chalume/CAP-CE6C-CRESUS/AXINT_CE6C_CRESUS/BOM proto-electronics PASSIF.xlsx

# | reference | value | Footprint | Ref Fabricant | Ref Fournisseur 1 | Quantity
1 | C30, C33, C34, C40, C41, C42, C43, C47, C49, C52, C54, C62, C63, C64, C65, C66, C67, C70, C71, C73, C77, C88, C92, C93, C95, C96, C98, C99, C100, C101 | 10nF_100V_0603 | C_0603_1608Metric | C0603X103K1RAC3316 | 399-C0603X103K1RAC3316CT-ND | 30
2 | C8, C12, C19, C20, C21, C22, C35, C36, C38, C48, C108, C109, C110, C111, C112, C113, C114, C115, C116, C117, C118, C119, C120, C121, C122, C123, C124, C125, C126 | 0.1µF_50V_0603 | C_0603_1608Metric | 06035C104KAT2A | 478-5052-1-ND | 29
3 | C1, C2, C3, C4, C5, C6, C7, C9, C24, C25, C26, C27, C28, C31, C51, C53, C59, C60, C68, C69, C80, C82, C83, C84, C85, C86 | 1µF_25V_0603 | C_0603_1608Metric | CL10B105KA8NNNC | 1276-1184-1-ND | 26
4 | C10, C13, C15, C16, C17, C18, C29, C61, C87, C89, C90, C91, C94, C97, C102, C103, C104, C105, C106, C107 | 10µF_16V_0603 | C_0603_1608Metric | JMK107BJ106MA-T | 587-1256-1-ND | 20
5 | C44, C45, C46, C50, C55, C56 | 1pF_50V_0603 | C_0603_1608Metric | 06031A1R0CAT2A | 478-4983-1-ND | 6
6 | C74, C75, C76, C78, C79, C81 | 10pF_50V_0603 | C_0603_1608Metric | CC0603JRNPO9BN100 | 311-1058-1-ND | 6
7 | C11, C23, C37, C57, C58 | 1µF_100V_1206 | C_1206_3216Metric | 12061C105KAT2A | 478-6226-1-ND | 5
8 | C14 | 1nF_100V_0603 | C_0603_1608Metric | C0603C102K1RAC7867 | 399-C0603C102K1RAC7867TR-ND | 1
9 | C32 | 10nF_50V_0603 | C_0603_1608Metric | CL10B103KB8NCNC | 1276-1921-1-ND | 1
10 | C39 | 0.1µF_100V_0603 | C_0603_1608Metric | CGA3E3X7S2A104K080AB | 445-6938-1-ND | 1
11 | C72 | 100µF_50V_radial | CP_Radial_D10.0mm_P5.00mm | EEU-FC1H101 | MAL215068101E3-ND | 1
12 | R20, R23, R24, R43, R44, R45, R46, R49, R50, R51, R52, R53, R54, R60, R61, R62, R63, R65, R66, R67, R78, R79, R80, R81, R82, R83, R84, R85, R86, R87 | 47Ω_0603 | R_0603_1608Metric | CRGCQ0603J47R | A130083CT-ND | 30
13 | R4, R5, R6, R7, R8, R10, R15, R16, R25, R39, R47, R55, R56, R57, R58, R59, R64, R68, R69, R91, R92, R95, R96, R97 | 200Ω_0603 | R_0603_1608Metric | ERA-3AEB201V | P200DBCT-ND | 24
14 | R18, R27, R28, R29, R40, R41, R42, R103, R104, R105, R106, R107, R108 | 10kΩ_0603 | R_0603_1608Metric | RMCF0603JT10K0 | RMCF0603JT10K0CT-ND | 13
15 | R1, R21, R70, R71, R72, R76, R77 | 1kΩ_0603 | R_0603_1608Metric | RC0603JR-071KL | 311-1.0KGRCT-ND | 7
16 | R3, R98, R99, R100, R101, R102 | 49,9kΩ_0603 | R_0603_1608Metric | RMCF0603FT49K9 | RMCF0603FT49K9CT-ND | 6
17 | R12, R13, R30, R31, R32, R33 | 10Ω_0603 | R_0603_1608Metric | RC0603FR-0710RL | 311-10.0HRCT-ND | 6
18 | R26, R88, R89, R90, R93, R94 | 100Ω_0603 | R_0603_1608Metric | RR0816P-101-D | RR08P100DCT-ND | 6
19 | R34, R35, R36, R37, R38, R48 | 2kΩ_0603-GLINCS_R | R_0603_1608Metric | RC0603FR-072KL | 311-2.00KHRCT-ND | 6
20 | R19, R22, R73, R74, R75 | 390Ω_0603 | R_0603_1608Metric | RR0816P-391-D | RR089390D-TR-ND | 5
21 | R2 | 120Ω_0603 | R_0603_1608Metric | RG1608P-121-B-T5 | RG16P120BCT-ND | 1
22 | R9 | 5.6kΩ_0603 | R_0603_1608Metric | RMCF0603JT5K60 | RMCF0603JT5K60CT-ND | 1
23 | R11 | 412kΩ_0603 | R_0603_1608Metric | RC0603FR-07412KL | 311-412KHRCT-ND | 1
24 | R14 | 100kΩ_0603 | R_0603_1608Metric | CR0603-JW-104ELF | CR0603-JW-104ELFCT-ND | 1
25 | R17 | 0Ω_0603 | R_0603_1608Metric | RC0603JR-070RL | 311-0.0GRTR-ND | 1
26 | L2 | 10UH_850mA | INDUCTOR_WE_3x3mm | 74438335100 | 732-4868-1-ND | 1
27 | D2, D3, D5, D10, D11, D12, D13 | SOD123_SCHOTTKY_70V | D_SOD-323 | 1N5711WS-7-F | 1N5711WS-FDICT-ND | 7
28 | D6, D7 | LED_RED_SMD_0603 | LED_0603_1608Metric | APT1608SRCPRV | 754-1122-1-ND | 2
29 | D8, D9 | LED_BLUE_SMD_0603 | LED_0603_1608Metric | APT1608QBC/D | 754-1434-1-ND | 2
30 | D1 | LM4040AIM3-2.0 | SOT-23 | LM4040AIM3-2.0/NOPB | 2463976 | 1
31 | D4 | LED_GREEN_RIGHT_ANGLED | LED_3.0mm_T1_Right_Angled_2mA | HLMP-1790-A00A2 | 1003385 | 1
32 | U1, U4, U9, U11, U16, U18 | LMH6655MA_NOPB | M08A_TEX | LMH6655MA_NOPB | LMH6655MA/NOPB-ND | 6
33 | U3, U19, U20, U21, U22, U23 | LTC6993IS6-2 | SOT-23-6_Handsoldering | LTC6993IS6-2#TRMPBF | LTC6993IS6-2#TRMPBFCT-ND | 6
34 | U5, U7, U14, U17, U24, U25 | LMH6654MF_NOPB | SOT-23-5_MC_MCH | LMH6654MF/NOPB | LMH6654MF/NOPBCT-ND | 6
35 | U13, U26, U28, U29, U30, U31 | DSPIC33EP512MC202-I_MM | QFN-S28_6x6MC_MCH | DSPIC33EP512MC202-I_MM | DSPIC33EP512MC202-I/MM-ND | 6
36 | U10, U12 | AD5504BRUZ | AD5504BRUZ | AD5504BRUZ | AD5504BRUZ-ND | 2
37 | U32, U34 | AD8564ARU-REEL | RU_16_ADI | AD8564ARU-REEL | 505-AD8564ARUZ-REELCT-ND | 2
38 | U2 | SN65HVD230D | SOIC-8_3.9x4.9mm_P1.27mm | SN65HVD230QDRQ1 | 296-11654-1-ND | 1
39 | U6 | DSPIC33EP512MC504-I/PT | DSPIC33EP512MC504-I&slash_PT | DSPIC33EP512MC504-I_PT | DSPIC33EP512MC504-I/PT-ND | 1
40 | U8 | LT8570 | MSOP-8-1EP_3x3mm_P0.65mm_EP1.68x1.88mm | LT8570EMS8E#PBF | LT8570EMS8E#PBF-ND | 1
41 | U15 | REG102-33 | SOT-23-5_HandSoldering | REG102NA-3.3/250 | REG102NA-3.3CT-ND | 1
42 | U27 | DC-DC_+-5V_8W | DC-DC_5V_8W | TEN 8-2421WI | 1951-2224-ND | 1
43 | U33 | AD5206BRUZ10 | RU_24_ADI | AD5206BRUZ10 | 505-AD5206BRUZ10-RL7CT-ND | 1
44 | SW1 | SW_DIP_x02 | SW_DIP_SPSTx02_Slide_6.7x32.04mm_W8.61mm_P2.54mm_LowProfile | EDS02SGRSTU04Q | 450-2621-ND | 1
45 | TP1, TP2, TP3, TP4, TP5, TP6, TP7, TP8, TP9, TP10, TP11, TP12, TP13, TP14, TP15, TP16, TP17, TP18 | TestPoint | TestPoint_Pad_D1.0mm |  |  | 18
46 | Q1, Q2, Q3, Q4, Q5, Q6 | BC817 | SOT-23 | BC817-40,215 | 1727-2919-2-ND | 6
47 | H1, H2 | MountingHole_Pad | MountingHole_2.7mm_Pad_EXTENDED |  |  | 2
48 | Z1 | AXINT_logo | AXINT_logo |  |  | 1
49 | Z2 | AVNIR_logo_27MM | AVNIR_LOGO_27MM |  |  | 1
50 | J2, J3, J9, J10, J11, J13, J14 | TAG-CONNECT_TC2030-DSPIC | TC2030-IDC-FP | TC2030-PKT |  | 7
51 | J1, J4, J6, J7, J8, J12 | TWINAXE_FACADE_CJT-T-P-HH-RA-BH1 | TWIN_BNC_SIDE_FACADE | CJT-T-P-HH-RA-BH1 | SAM9214-ND | 6
52 | J5 | Connecteur_Fond_De_Panier_Male_64_Voies | HARTING_64_M | 9021646951 | 1195-1096-ND | 1
