chalume/CAP-CE6C-CRESUS/AXINT_CE6C_CRESUS/AXINT_CE6C_CRESUS.kicad_sch

## KiCad design AXINT_CE6C_CRESUS/AXINT_CE6C_CRESUS.kicad_sch (2025-07-21)

Schematic: AXINT_CE6C_CRESUS.kicad_sch

Parts:
C1, C2, C3, C4, C5, C6, C7, C9, C24, C25, C26, C27, C28, C31, C51, C53, C59, C60, C68, C69, C80, C82, C83, C84, C85, C86: 1µF_25V_0603; C_0603_1608Metric
C8, C12, C19, C20, C21, C22, C35, C36, C38, C48, C108, C109, C110, C111, C112, C113, C114, C115, C116, C117, C118, C119, C120, C121, C122, C123, C124, C125, C126: 0.1µF_50V_0603; C_0603_1608Metric
C10, C13, C15, C16, C17, C18, C29, C61, C87, C89, C90, C91, C94, C97, C102, C103, C104, C105, C106, C107: 10µF_16V_0603; C_0603_1608Metric
C11, C23, C37, C57, C58: 1µF_100V_1206; C_1206_3216Metric
C14: 1nF_100V_0603; C_0603_1608Metric
C30, C33, C34, C40, C41, C42, C43, C47, C49, C52, C54, C62, C63, C64, C65, C66, C67, C70, C71, C73, C77, C88, C92, C93, C95, C96, C98, C99, C100, C101: 10nF_100V_0603; C_0603_1608Metric
C32: 10nF_50V_0603; C_0603_1608Metric
C39: 0.1µF_100V_0603; C_0603_1608Metric
C44, C45, C46, C50, C55, C56: 1pF_50V_0603; C_0603_1608Metric
C72: 100µF_50V_radial; CP_Radial_D10.0mm_P5.00mm
C74, C75, C76, C78, C79, C81: 10pF_50V_0603; C_0603_1608Metric
D1: LM4040AIM3-2.0; SOT-23
D2, D3, D5, D10, D11, D12, D13: SOD123_SCHOTTKY_70V; D_SOD-323
D4: LED_GREEN_RIGHT_ANGLED; LED_3.0mm_T1_Right_Angled_2mA
D6, D7: LED_RED_SMD_0603; LED_0603_1608Metric
D8, D9: LED_BLUE_SMD_0603; LED_0603_1608Metric
H1, H2: MountingHole_Pad; MountingHole_2.7mm_Pad_EXTENDED
J1, J4, J6, J7, J8, J12: TWINAXE_FACADE_CJT-T-P-HH-RA-BH1; TWIN_BNC_SIDE_FACADE
J2, J3, J9, J10, J11, J13, J14: TAG-CONNECT_TC2030-DSPIC; TC2030-IDC-FP
J5: Connecteur_Fond_De_Panier_Male_64_Voies; HARTING_64_M; Mouser Part Number 617-09021646951
L2: 10UH_850mA; INDUCTOR_WE_3x3mm
Q1, Q2, Q3, Q4, Q5, Q6: BC817; SOT-23
R1, R21, R70, R71, R72, R76, R77: 1kΩ_0603; R_0603_1608Metric
R2: 120Ω_0603; R_0603_1608Metric
R3, R98, R99, R100, R101, R102: 49,9kΩ_0603; R_0603_1608Metric
R4, R5, R6, R7, R8, R10, R15, R16, R25, R39, R47, R55, R56, R57, R58, R59, R64, R68, R69, R91, R92, R95, R96, R97: 200Ω_0603; R_0603_1608Metric
R9: 5.6kΩ_0603; R_0603_1608Metric
R11: 412kΩ_0603; R_0603_1608Metric
R12, R13, R30, R31, R32, R33: 10Ω_0603; R_0603_1608Metric
R14: 100kΩ_0603; R_0603_1608Metric
R17: 0Ω_0603; R_0603_1608Metric
R18, R27, R28, R29, R40, R41, R42, R103, R104, R105, R106, R107, R108: 10kΩ_0603; R_0603_1608Metric
R19, R22, R73, R74, R75: 390Ω_0603; R_0603_1608Metric
R20, R23, R24, R43, R44, R45, R46, R49, R50, R51, R52, R53, R54, R60, R61, R62, R63, R65, R66, R67, R78, R79, R80, R81, R82, R83, R84, R85, R86, R87: 47Ω_0603; R_0603_1608Metric
R26, R88, R89, R90, R93, R94: 100Ω_0603; R_0603_1608Metric
R34, R35, R36, R37, R38, R48: 2kΩ_0603-GLINCS_R; R_0603_1608Metric
SW1: SW_DIP_x02; SW_DIP_SPSTx02_Slide_6.7x32.04mm_W8.61mm_P2.54mm_LowProfile
TP1, TP2, TP3, TP4, TP5, TP6, TP7, TP8, TP9, TP10, TP11, TP12, TP13, TP14, TP15, TP16, TP17, TP18: TestPoint; TestPoint_Pad_D1.0mm
U1, U4, U9, U11, U16, U18: LMH6655MA_NOPB; M08A_TEX
U2: SN65HVD230D; SOIC-8_3.9x4.9mm_P1.27mm
U3, U19, U20, U21, U22, U23: LTC6993IS6-2; SOT-23-6_Handsoldering
U5, U7, U14, U17, U24, U25: LMH6654MF_NOPB; SOT-23-5_MC_MCH
U6: DSPIC33EP512MC504-I/PT; DSPIC33EP512MC504-I&slash_PT
U8: LT8570; MSOP-8-1EP_3x3mm_P0.65mm_EP1.68x1.88mm
U10, U12: AD5504BRUZ
U13, U26, U28, U29, U30, U31: DSPIC33EP512MC202-I_MM; QFN-S28_6x6MC_MCH
U15: REG102-33; SOT-23-5_HandSoldering
U27: DC-DC_+-5V_8W; DC-DC_5V_8W
U32, U34: AD8564ARU-REEL; RU_16_ADI
U33: AD5206BRUZ10; RU_24_ADI
Z1: AXINT_logo
Z2: AVNIR_logo_27MM; AVNIR_LOGO_27MM

Connections:
+3.3V: C8.1, C20.1, C21.1, C22.1, C31.2, C35.1, C36.1, C38.1, C48.1, C108.1, C109.1, C110.1, C111.1, C112.1, C113.1, C114.1, C115.1, C116.1, C117.1, C118.1, C119.1, C126.1, J5.A8, J5.B8, R1.1, R18.1, R103.1, R104.1, R105.1, R106.1, R107.1, R108.1, U2.3 (VCC), U3.5 (V+), U6.17 (AVDD), U6.28 (VDD), U6.40 (VDD), U10.1 (*CLR), U10.13 (*R_SEL), U10.16 (VLOGIC), U12.1 (*CLR), U12.13 (*R_SEL), U12.16 (VLOGIC), U13.10 (VDD), U13.25 (AVDD), U15.5 (OUT), U19.5 (V+), U20.5 (V+), U21.5 (V+), U22.5 (V+), U23.5 (V+), U26.10 (VDD), U26.25 (AVDD), U28.10 (VDD), U28.25 (AVDD), U29.10 (VDD), U29.25 (AVDD), U30.10 (VDD), U30.25 (AVDD), U31.10 (VDD), U31.25 (AVDD), U32.11 (V+DIG), U32.14 (V+ANA), U33.6 (VDD), U34.11 (V+DIG), U34.14 (V+ANA)
+5V: C4.1, C5.1, C6.1, C7.1, C9.1, C25.1, C28.2, C33.1, C51.1, C53.1, C57.1, C58.1, C59.1, C60.1, C62.1, C63.1, C64.1, C65.1, C68.1, C69.1, C70.1, C71.1, C73.1, C77.1, C99.1, C100.1, C101.1, L2.1, U1.8 (V+), U4.8 (V+), U5.5 (V+), U7.5 (V+), U8.3 (VIN), U8.5 (~SHDN), U9.8 (V+), U11.8 (V+), U14.5 (V+), U15.1 (IN), U15.3 (EN), U16.8 (V+), U17.5 (V+), U18.8 (V+), U24.5 (V+), U25.5 (V+), U27.14 (+Vout)
+24V: C72.1, J5.A32, J5.B32, U27.22 (+Vin_(Vcc)), U27.23 (+Vin_(Vcc))
-5V: C1.1, C2.1, C3.1, C24.1, C26.1, C27.1, C30.1, C34.1, C40.1, C41.1, C42.1, C43.1, C80.1, C82.1, C83.1, C84.1, C85.1, C86.1, C88.1, C92.1, C93.1, C95.1, C96.1, C98.1, U1.4 (V-), U4.4 (V-), U5.2 (V-), U7.2 (V-), U9.4 (V-), U11.4 (V-), U14.2 (V-), U16.4 (V-), U17.2 (V-), U18.4 (V-), U24.2 (V-), U25.2 (V-), U27.11 (-Vout)
BIAS_SIPM1: R20.2, U12.12 (VOUTA)
BIAS_SIPM2: R43.2, U12.11 (VOUTB)
BIAS_SIPM3: R44.2, U12.10 (VOUTC)
BIAS_SIPM4: R45.2, U12.9 (VOUTD)
BIAS_SIPM5: R46.2, U10.12 (VOUTA)
BIAS_SIPM6: R67.2, U10.11 (VOUTB)
CANH: J5.A1, SW1.2, U2.7 (CANH)
CANL: J5.B1, SW1.1, U2.6 (CANL)
CAN_ID_0: J5.B7, R27.2, U6.13 (TDI/RA7)
CAN_ID_1: J5.B6, R28.2, U6.14 (RPI46/PWM1H/T3CK/RB14)
CAN_ID_2: J5.B5, R29.2, U6.15 (RPI47/PWM1L/T5CK/RB15)
CAN_ID_3: J5.B4, R40.2, U6.21 (PGED3/VREF-/AN2/C2IN1-/*SS1/RPI32/CTED2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)
CAN_ID_4: J5.B3, R41.2, U6.22 (PGEC3/VREF+/AN3/OA1OUT/RPI33/CTED1/RB1)
CAN_ID_5: J5.B2, R42.2, U6.33 (FLT32/SCL2/RP36/RB4)
CLK1_COMM: U6.36 (SCK1/RPI51/RC3), U13.13 (SCK1/RP39/INT0/RB7), U26.13 (SCK1/RP39/INT0/RB7), U28.13 (SCK1/RP39/INT0/RB7), U29.13 (SCK1/RP39/INT0/RB7), U30.13 (SCK1/RP39/INT0/RB7), U31.13 (SCK1/RP39/INT0/RB7)
CLK2_DAC_POT: U6.1 (TMS/ASDA1/RP41/RB9), U10.3 (SCLK), U12.3 (SCLK), U33.8 (CLK)
CRETE1: C47.2, Q1.3 (C), R23.2, R24.1, TP4.1, U13.2 (PGEC3/VREF+/AN3/OA1OUT/RPI33/CTED1/RB1)
CRETE2: C66.2, Q5.3 (C), R81.1, R86.2, TP12.1, U31.2 (PGEC3/VREF+/AN3/OA1OUT/RPI33/CTED1/RB1)
CRETE3: C67.2, Q6.3 (C), R82.1, R87.2, TP13.1, U30.2 (PGEC3/VREF+/AN3/OA1OUT/RPI33/CTED1/RB1)
CRETE4: C54.2, Q4.3 (C), R80.1, R85.2, TP11.1, U29.2 (PGEC3/VREF+/AN3/OA1OUT/RPI33/CTED1/RB1)
CRETE5: C49.2, Q2.3 (C), R78.1, R83.2, TP9.1, U28.2 (PGEC3/VREF+/AN3/OA1OUT/RPI33/CTED1/RB1)
CRETE6: C52.2, Q3.3 (C), R79.1, R84.2, TP10.1, U26.2 (PGEC3/VREF+/AN3/OA1OUT/RPI33/CTED1/RB1)
D: U2.1 (D), U6.5 (RP57/RC9)
GND: C1.2, C2.2, C3.2, C4.2, C5.2, C6.2, C7.2, C8.2, C9.2, C11.2, C12.2, C14.2, C16.2, C18.2, C19.2, C20.2, C21.2, C22.2, C23.2, C24.2, C25.2, C26.2, C27.2, C28.1, C30.2, C31.1, C32.2, C33.2, C34.2, C35.2, C36.2, C37.2, C38.2, C39.1, C40.2, C41.2, C42.2, C43.2, C47.1, C48.2, C49.1, C51.2, C52.1, C53.2, C54.1, C57.2, C58.2, C59.2, C60.2, C62.2, C63.2, C64.2, C65.2, C66.1, C67.1, C68.2, C69.2, C70.2, C71.2, C72.2, C73.2, C77.2, C80.2, C82.2, C83.2, C84.2, C85.2, C86.2, C88.2, C92.2, C93.2, C95.2, C96.2, C98.2, C99.2, C100.2, C101.2, C102.2, C103.2, C104.2, C105.2, C106.2, C107.2, C108.2, C109.2, C110.2, C111.2, C112.2, C113.2, C114.2, C115.2, C116.2, C117.2, C118.2, C119.2, C120.2, C121.2, C122.2, C123.2, C124.2, C125.2, C126.2, D1.2 (A), D4.1 (K), D6.1 (K), D7.1 (K), D8.1 (K), D9.1 (K), H1.1, H2.1, J1.3 (SHLD), J2.2 (GND), J3.2 (GND), J4.3 (SHLD), J5.A11, J5.A12, J5.A13, J5.A14, J5.A15, J5.A16, J5.A17, J5.A18, J5.A19, J5.A20, J5.A21, J5.A22, J5.A23, J5.A24, J5.A25, J5.A26, J5.A27, J5.A28, J5.A29, J5.A30, J5.B11, J5.B12, J5.B13, J5.B14, J5.B15, J5.B16, J5.B17, J5.B18, J5.B19, J5.B20, J5.B21, J5.B22, J5.B23, J5.B24, J5.B25, J5.B26, J5.B27, J5.B28, J5.B29, J5.B30, J6.3 (SHLD), J7.3 (SHLD), J8.3 (SHLD), J9.2 (GND), J10.2 (GND), J11.2 (GND), J12.3 (SHLD), J13.2 (GND), J14.2 (GND), R3.1, R4.1, R5.1, R6.1, R7.1, R8.1, R10.1, R14.2, R17.2, R26.2, R27.1, R28.1, R29.1, R40.1, R41.1, R42.1, R55.1, R56.1, R57.1, R58.1, R59.1, R64.1, R88.2, R89.2, R90.2, R93.2, R94.2, R98.1, R99.1, R100.1, R101.1, R102.1, U1.3 (IN+), U2.2 (GND), U3.2 (GND), U4.3 (IN+), U5.3 (+), U6.6 (VSS), U6.16 (AVSS), U6.19 (AN0/OA2OUT/RA0), U6.29 (VSS), U6.39 (VSS), U7.3 (+), U8.8 (SYNC), U8.9 (GND), U9.3 (IN+), U10.6 (DGND), U10.7 (AGND), U10.8 (*LDAC), U11.3 (IN+), U12.6 (DGND), U12.7 (AGND), U12.8 (*LDAC), U13.5 (VSS), U13.16 (VSS), U13.24 (AVSS), U13.27 (AN0/OA2OUT/RA0), U14.3 (+), U15.2 (GND), U16.3 (IN+), U17.3 (+), U18.3 (IN+), U19.2 (GND), U20.2 (GND), U21.2 (GND), U22.2 (GND), U23.2 (GND), U24.3 (+), U25.3 (+), U26.5 (VSS), U26.16 (VSS), U26.24 (AVSS), U26.27 (AN0/OA2OUT/RA0), U27.2 (-Vin_(GND)), U27.3 (-Vin_(GND)), U27.9 (Common_(GND)), U27.16 (Common_(GND)), U28.5 (VSS), U28.16 (VSS), U28.24 (AVSS), U28.27 (AN0/OA2OUT/RA0), U29.5 (VSS), U29.16 (VSS), U29.24 (AVSS), U29.27 (AN0/OA2OUT/RA0), U30.5 (VSS), U30.16 (VSS), U30.24 (AVSS), U30.27 (AN0/OA2OUT/RA0), U31.5 (VSS), U31.16 (VSS), U31.24 (AVSS), U31.27 (AN0/OA2OUT/RA0), U32.3 (GND), U32.6 (V-ANA), U33.3 (B6), U33.4 (GND), U33.9 (VSS), U33.10 (B5), U33.13 (B3), U33.16 (B1), U33.21 (B2), U33.24 (B4), U34.3 (GND), U34.6 (V-ANA)
LED4: R19.1, U6.32 (SDA2/RPI24/RA8)
LED6: R22.1, U6.30 (OSC1/CLKI/RA2)
LED7: R73.1, U6.25 (AN6/OA3OUT/C4IN1+/OCFB/RC0)
LED8: R74.1, U6.37 (SDA1/RPI52/RC4)
LED9: R75.1, U6.38 (SCL1/RPI53/RC5)
MONO1: TP3.1, U3.6 (OUT), U13.8 (FLT32/RP36/RB4)
MONO2: TP17.1, U22.6 (OUT), U31.8 (FLT32/RP36/RB4)
MONO3: TP18.1, U23.6 (OUT), U30.8 (FLT32/RP36/RB4)
MONO4: TP16.1, U21.6 (OUT), U29.8 (FLT32/RP36/RB4)
MONO5: TP15.1, U20.6 (OUT), U28.8 (FLT32/RP36/RB4)
MONO6: TP14.1, U19.6 (OUT), U26.8 (FLT32/RP36/RB4)
unnamed: C10.1, R12.1
unnamed: C11.1, C14.1, C23.1, R9.1
unnamed: C13.1, R13.1
unnamed: C15.1, R30.1
unnamed: C17.1, R31.1
unnamed: C29.1, R32.1
unnamed: C32.1, U15.4 (NR)
unnamed: C39.2, U8.7 (SS)
unnamed: C44.1, D3.2 (A), U18.7 (OUT)
unnamed: C44.2, R24.2, U18.6 (IN-)
unnamed: C45.1, D5.2 (A), U1.7 (OUT)
unnamed: C45.2, R78.2, U1.6 (IN-)
unnamed: C46.1, D10.2 (A), U4.7 (OUT)
unnamed: C46.2, R79.2, U4.6 (IN-)
unnamed: C50.1, D11.2 (A), U9.7 (OUT)
unnamed: C50.2, R80.2, U9.6 (IN-)
unnamed: C55.1, D12.2 (A), U11.7 (OUT)
unnamed: C55.2, R81.2, U11.6 (IN-)
unnamed: C56.1, D13.2 (A), U16.7 (OUT)
unnamed: C56.2, R82.2, U16.6 (IN-)
unnamed: C61.1, R33.1
unnamed: C74.1, R34.2, R49.1, U14.1
unnamed: C74.2, R12.2, R34.1, U14.4 (-)
unnamed: C75.1, R35.2, R50.1, U5.1
unnamed: C75.2, R13.2, R35.1, U5.4 (-)
unnamed: C76.1, R36.2, R51.1, U7.1
unnamed: C76.2, R30.2, R36.1, U7.4 (-)
unnamed: C78.1, R37.2, R52.1, U24.1
unnamed: C78.2, R31.2, R37.1, U24.4 (-)
unnamed: C79.1, R38.2, R53.1, U17.1
unnamed: C79.2, R32.2, R38.1, U17.4 (-)
unnamed: C81.1, R48.2, R54.1, U25.1
unnamed: C81.2, R33.2, R48.1, U25.4 (-)
unnamed: C87.1, R55.2, R60.1
unnamed: C87.2, R49.2
unnamed: C89.1, R56.2, R61.1
unnamed: C89.2, R50.2
unnamed: C90.1, R57.2, R62.1
unnamed: C90.2, R51.2
unnamed: C91.1, R58.2, R63.1
unnamed: C91.2, R52.2
unnamed: C94.1, R59.2, R65.1
unnamed: C94.2, R53.2
unnamed: C97.1, R64.2, R66.1
unnamed: C97.2, R54.2
unnamed: D2.2 (A), L2.2, U8.4 (SW)
unnamed: D3.1 (K), R23.1
unnamed: D4.2 (A), R19.2
unnamed: D5.1 (K), R83.1
unnamed: D6.2 (A), R22.2
unnamed: D7.2 (A), R73.2
unnamed: D8.2 (A), R74.2
unnamed: D9.2 (A), R75.2
unnamed: D10.1 (K), R84.1
unnamed: D11.1 (K), R85.1
unnamed: D12.1 (K), R86.1
unnamed: D13.1 (K), R87.1
unnamed: Q1.1 (B), R25.1
unnamed: Q1.2 (E), R26.1
unnamed: Q2.1 (B), R91.1
unnamed: Q2.2 (E), R88.1
unnamed: Q3.1 (B), R92.1
unnamed: Q3.2 (E), R89.1
unnamed: Q4.1 (B), R95.1
unnamed: Q4.2 (E), R90.1
unnamed: Q5.1 (B), R96.1
unnamed: Q5.2 (E), R93.1
unnamed: Q6.1 (B), R97.1
unnamed: Q6.2 (E), R94.1
unnamed: R2.1, SW1.3
unnamed: R2.2, SW1.4
unnamed: R3.2, U3.3 (SET)
unnamed: R9.2, U8.2 (VC)
unnamed: R11.2, U8.1 (FBX)
unnamed: R14.1, U8.6 (RT)
unnamed: R15.2, R66.2, U18.2 (IN-)
unnamed: R16.2, R61.2, U1.2 (IN-)
unnamed: R17.1, U2.8 (Rs/(GND))
unnamed: R21.2, U18.5 (IN+)
unnamed: R39.2, R62.2, U4.2 (IN-)
unnamed: R47.2, R60.2, U9.2 (IN-)
unnamed: R63.2, R69.2, U16.2 (IN-)
unnamed: R65.2, R68.2, U11.2 (IN-)
unnamed: R70.2, U1.5 (IN+)
unnamed: R71.2, U4.5 (IN+)
unnamed: R72.2, U9.5 (IN+)
unnamed: R76.2, U11.5 (IN+)
unnamed: R77.2, U16.5 (IN+)
unnamed: R98.2, U19.3 (SET)
unnamed: R99.2, U20.3 (SET)
unnamed: R100.2, U21.3 (SET)
unnamed: R101.2, U22.3 (SET)
unnamed: R102.2, U23.3 (SET)
PGC: J3.3 (PGC), U6.23 (PGEC1/AN4/C1IN1+/RPI34/RB2)
PGC1: J13.3 (PGC), U13.3 (PGEC1/AN4/C1IN1+/RPI34/RB2)
PGC2: J14.3 (PGC), U31.3 (PGEC1/AN4/C1IN1+/RPI34/RB2)
PGC3: J11.3 (PGC), U30.3 (PGEC1/AN4/C1IN1+/RPI34/RB2)
PGC4: J10.3 (PGC), U29.3 (PGEC1/AN4/C1IN1+/RPI34/RB2)
PGC5: J9.3 (PGC), U28.3 (PGEC1/AN4/C1IN1+/RPI34/RB2)
PGC6: J2.3 (PGC), U26.3 (PGEC1/AN4/C1IN1+/RPI34/RB2)
PGD: J3.5 (PGD), U6.24 (PGED1/AN5/C1IN1-/RP35/RB3)
PGD1: J13.5 (PGD), U13.4 (PGED1/AN5/C1IN1-/RP35/RB3)
PGD2: J14.5 (PGD), U31.4 (PGED1/AN5/C1IN1-/RP35/RB3)
PGD3: J11.5 (PGD), U30.4 (PGED1/AN5/C1IN1-/RP35/RB3)
PGD4: J10.5 (PGD), U29.4 (PGED1/AN5/C1IN1-/RP35/RB3)
PGD5: J9.5 (PGD), U28.4 (PGED1/AN5/C1IN1-/RP35/RB3)
PGD6: J2.5 (PGD), U26.4 (PGED1/AN5/C1IN1-/RP35/RB3)
PW1: U32.1 (IN_A-), U33.17 (W1)
PW2: U32.8 (IN_B-), U33.20 (W2)
PW3: U32.16 (IN_D-), U33.14 (W3)
PW4: U32.9 (IN_C-), U33.23 (W4)
PW5: U33.11 (W5), U34.1 (IN_A-)
PW6: U33.2 (W6), U34.8 (IN_B-)
R: U2.4 (R), U6.4 (RP56/RC8)
RAZ1: R25.2, U13.12 (PGEC2/ASCL2/RP38/RB6)
RAZ2: R96.2, U31.12 (PGEC2/ASCL2/RP38/RB6)
RAZ3: R97.2, U30.12 (PGEC2/ASCL2/RP38/RB6)
RAZ4: R95.2, U29.12 (PGEC2/ASCL2/RP38/RB6)
RAZ5: R91.2, U28.12 (PGEC2/ASCL2/RP38/RB6)
RAZ6: R92.2, U26.12 (PGEC2/ASCL2/RP38/RB6)
REF2V5: C12.1, C16.1, D1.1 (K), R1.2, U33.1 (A6), U33.12 (A5), U33.15 (A3), U33.18 (A1), U33.19 (A2), U33.22 (A4)
SDI1_COMM: U6.35 (SDI1/RPI25/RA9), U13.14 (TCK/CVREF1O/ASCL1/SDO1/RP40/T4CK/RB8), U26.14 (TCK/CVREF1O/ASCL1/SDO1/RP40/T4CK/RB8), U28.14 (TCK/CVREF1O/ASCL1/SDO1/RP40/T4CK/RB8), U29.14 (TCK/CVREF1O/ASCL1/SDO1/RP40/T4CK/RB8), U30.14 (TCK/CVREF1O/ASCL1/SDO1/RP40/T4CK/RB8), U31.14 (TCK/CVREF1O/ASCL1/SDO1/RP40/T4CK/RB8)
SDI2_DAC_POT: U6.8 (RP42/PWM3H/RB10), U10.5 (SDO), U12.5 (SDO)
SDO1_COMM: U6.34 (CVREF20/SDO1/RP20/T1CK/RA4), U13.15 (TMS/ASDA1/SDI1/RP41/RB9), U26.15 (TMS/ASDA1/SDI1/RP41/RB9), U28.15 (TMS/ASDA1/SDI1/RP41/RB9), U29.15 (TMS/ASDA1/SDI1/RP41/RB9), U30.15 (TMS/ASDA1/SDI1/RP41/RB9), U31.15 (TMS/ASDA1/SDI1/RP41/RB9)
SDO2_DAC_POT: U6.41 (PGED2/ASDA2/RP37/RB5), U10.4 (SDI), U12.4 (SDI), U33.7 (SDI)
SIG1: C61.2, J12.1 (In), R10.2
SIG2: C29.2, J1.1 (In), R8.2
SIG3: C17.2, J4.1 (In), R7.2
SIG4: C10.2, J6.1 (In), R4.2
SIG5: C13.2, J7.1 (In), R5.2
SIG6: C15.2, J8.1 (In), R6.2
SIGNAL1: R15.1, R21.1, TP2.1, U18.1 (OUT), U32.2 (IN_A+)
SIGNAL2: R68.1, R76.1, TP7.1, U11.1 (OUT), U32.7 (IN_B+)
SIGNAL3: R69.1, R77.1, TP8.1, U16.1 (OUT), U32.15 (IN_D+)
SIGNAL4: R47.1, R72.1, TP6.1, U9.1 (OUT), U32.10 (IN_C+)
SIGNAL5: R16.1, R70.1, TP1.1, U1.1 (OUT), U34.2 (IN_A+)
SIGNAL6: R39.1, R71.1, TP5.1, U4.1 (OUT), U34.7 (IN_B+)
SIPM1: J12.2 (In), R20.1
SIPM2: J1.2 (In), R43.1
SIPM3: J4.2 (In), R44.1
SIPM4: J6.2 (In), R45.1
SIPM5: J7.2 (In), R46.1
SIPM6: J8.2 (In), R67.1
TRIGG1: U3.1 (TRIGG), U32.4 (OUT_A)
TRIGG2: U22.1 (TRIGG), U32.5 (OUT_B)
TRIGG3: U23.1 (TRIGG), U32.12 (OUT_C)
TRIGG4: U21.1 (TRIGG), U32.13 (OUT_D)
TRIGG5: U20.1 (TRIGG), U34.4 (OUT_A)
TRIGG6: U19.1 (TRIGG), U34.5 (OUT_B)
VBOOST: C37.1, D2.1 (K), R11.1, U10.14 (VDD), U12.14 (VDD)
VCAP: C18.1, U6.7 (VCAP)
VCAP1: C106.1, U13.17 (VCAP)
VCAP2: C107.1, U31.17 (VCAP)
VCAP3: C105.1, U30.17 (VCAP)
VCAP4: C104.1, U29.17 (VCAP)
VCAP5: C103.1, U28.17 (VCAP)
VCAP6: C102.1, U26.17 (VCAP)
~CS2_DAC2: U6.10 (RPI44/PWM2H/RB12), U10.2 (*SYNC)
~CS_COMM_1: U6.42 (PGEC2/ASCL2/RP38/RB6), U13.28 (AN1/C2IN1+/RA1)
~CS_COMM_2: U6.44 (TCK/CVREF10/ASCL1/RP40/T4CK/RB8), U31.28 (AN1/C2IN1+/RA1)
~CS_COMM_3: U6.31 (OSC2/CLKO/RA3), U30.28 (AN1/C2IN1+/RA1)
~CS_COMM_4: U6.27 (AN8/C3IN1+/*U1RTS/BCLK1/FLT3/RC2), U29.28 (AN1/C2IN1+/RA1)
~CS_COMM_5: U6.11 (RPI45/PWM2L/CTPLS/RB13), U28.28 (AN1/C2IN1+/RA1)
~CS_COMM_6: U6.12 (TDO/RA10), U26.28 (AN1/C2IN1+/RA1)
~CS_DAC1: U6.9 (RP43/PWM3L/RB11), U12.2 (*SYNC)
~CS_POT1: U6.3 (RP55/RC7), U33.5 (CS*)
~MCLR1: C121.1, J13.1 (MCLR), R104.2, U13.26 (*MCLR)
~MCLR2: C125.1, J14.1 (MCLR), R108.2, U31.26 (*MCLR)
~MCLR3: C123.1, J11.1 (MCLR), R106.2, U30.26 (*MCLR)
~MCLR4: C124.1, J10.1 (MCLR), R107.2, U29.26 (*MCLR)
~MCLR5: C122.1, J9.1 (MCLR), R105.2, U28.26 (*MCLR)
~MCLR6: C120.1, J2.1 (MCLR), R103.2, U26.26 (*MCLR)
~MCLR: C19.1, J3.1 (MCLR), R18.2, U6.18 (*MCLR)

Notes on the sheet:
ALIM 3V3 250mA dsPIC
Interface de programmation PIC VOIE 6
Interface de programmation PIC VOIE 5
RETEX PROTOTYPE / MODIFICATIONS DE ROUTAGE A EFFECTUER SUR LA PROCHAINE VERSION DEBUG : Ajout de 2 ou 3 LED debug sur les PICS slaves ROUTAGE : 1) Connexion VREF- OU AN1 au GND pour ADC 12 bits. VREF- conflit avec /SS1 donc -->AN1 2) Correction CS : entrer /CS slaves sur SS1 (PIN1) 3) Filtregae ali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
TP1 : BIAS SiPM TP2 : SIGNAL 2 TP3 : MONO2 TP4 : CRETE 1 TP5 : MID (PD après preamp) TP6 : ADC_SELECT TP7 : TO_ADC
Interface de programmation PIC PRINCIPAL
Montage proto 15 juillet 2025 diode 1N4148 R24 10K R23 0R
Interface de programmation PIC VOIE 3
Interface de programmation PIC VOIE 2
Interface de programmation PIC VOIE 1
Interface de programmation PIC VOIE 4
REWORK A FAIRE TOPOLOGIE D'ALIMENTATION INPUT [+24V in] → FB (BLM21PG600SN1D)→ + → L (744272471) → + → 2X TRS VIN (TRS2-2421 +/- 5V et TRS2-2410 3V3) | | 10uF 50V 100nF 50V | | GND GND Sortie de TRS : 3x [VOUT TRS] → [ FB (BLM21PG600SN1D)] → 10uF 50V 100nF 50V [LDO] LDO +/-5V LT3042/LT3090 : besoin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
Potentiometre : remplacer par AD5206 6 voies
Vers carte AVNIR_AXINT_FOND_DE_PANIER_CAP
